adafruit/Adafruit-TLV320DAC3100-I2S-DAC-PCB/Adafruit TLV320DAC3100 I2S DAC.brd

## EAGLE design Adafruit TLV320DAC3100 I2S DAC.brd (2025-03-27)

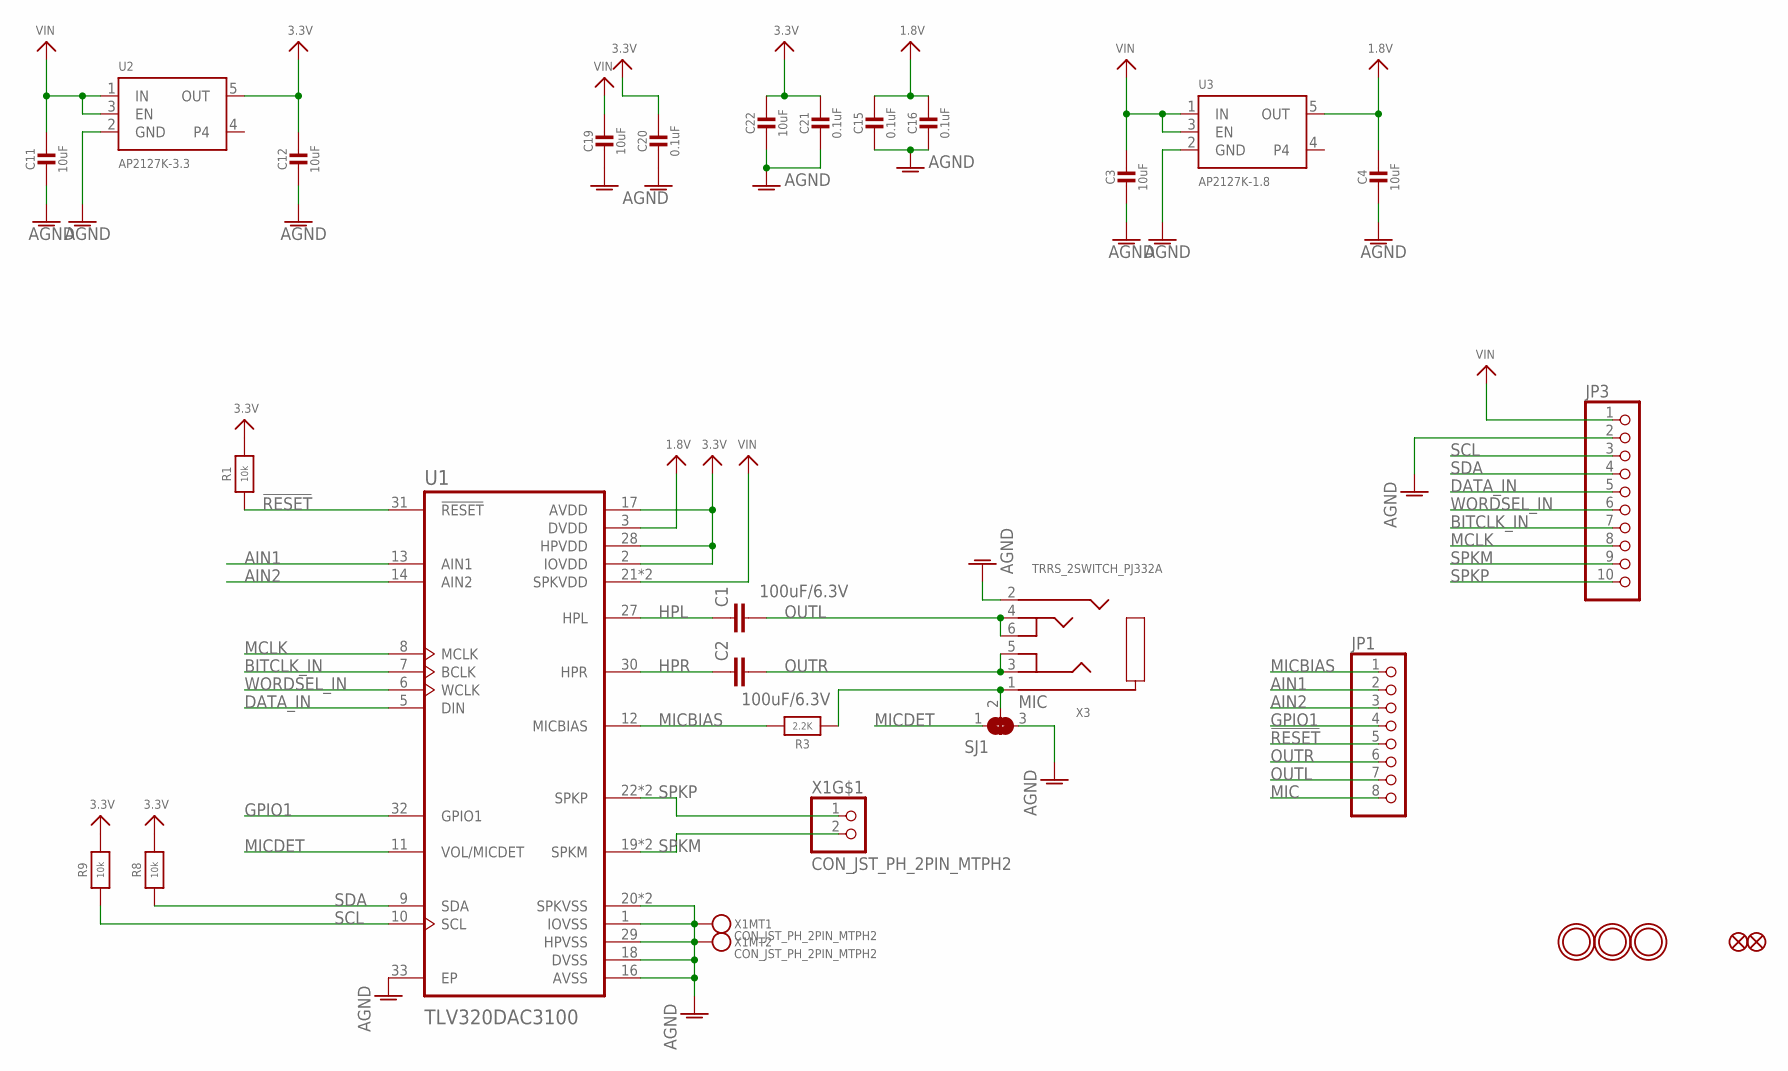
[picture p2: schematic Adafruit TLV320DAC3100 I2S DAC.sch]

Parts:
C1, C2: 100uF/6.3V; C1210
C3, C4, C11, C12, C19, C22: 10uF; 0805-NO
C15, C16, C20, C21: 0.1uF; 0603-NO
FID1, FID2: FIDUCIAL_0.5MM
JP1: HEADER-1X870MIL; 1X08_ROUND_70
JP3: HEADER-1X1070MIL; 1X10_ROUND70
R1, R8, R9: 10k; 0603-NO
R3: 2.2K; 0603-NO
SJ1: SOLDERJUMPER_2WAY; SOLDERJUMPER_2WAY_OPEN_NOPASTE
U1: TLV320DAC3100
U2: AP2127K-3.3; SOT23-5
U3: AP2127K-1.8; SOT23-5
U$12, U$13, U$14: MOUNTINGHOLE2.5; MOUNTINGHOLE_2.5_PLATED
X1: CON_JST_PH_2PIN_MTPH2; JSTPH2
X3: TRRS_2SWITCH_PJ332A; PJ-332A

Connections:
1.8V: C4.1, C15.1, C16.1, U1.3 (DVDD), U3.5 (OUT)
3.3V: C12.1, C20.1, C21.1, C22.1, R1.2, R8.2, R9.2, U1.2 (IOVDD), U1.17 (AVDD), U1.28 (HPVDD), U2.5 (OUT)
!RESET: JP1.5, R1.1, U1.31 (!RESET)
AGND: C3.2, C4.2, C11.2, C12.2, C15.2, C16.2, C19.2, C20.2, C21.2, C22.2, JP3.2, SJ1.3, U1.1 (IOVSS), U1.16 (AVSS), U1.18 (DVSS), U1.20 (SPKVSS), U1.25 (SPKVSS), U1.29 (HPVSS), U1.33 (EP), U2.2 (GND), U3.2 (GND), X1.NC1, X1.NC2, X3.2 (RING1)
AIN1: JP1.2, U1.13 (AIN1)
AIN2: JP1.3, U1.14 (AIN2)
BITCLK_IN: JP3.7, U1.7 (BCLK)
DATA_IN: JP3.5, U1.5 (DIN)
GPIO1: JP1.4, U1.32 (GPIO1)
HPL: C1.1, U1.27 (HPL)
HPR: C2.1, U1.30 (HPR)
MCLK: JP3.8, U1.8 (MCLK)
MIC: JP1.8, R3.1, SJ1.2, X3.1 (RING)
MICBIAS: JP1.1, R3.2, U1.12 (MICBIAS)
MICDET: SJ1.1, U1.11 (VOL/MICDET)
OUTL: C1.2, JP1.7, X3.4 (TIP), X3.6 (TIP_SW)
OUTR: C2.2, JP1.6, X3.3 (RING2), X3.5 (R2_SW)
SCL: JP3.3, R9.1, U1.10 (SCL)
SDA: JP3.4, R8.1, U1.9 (SDA)
SPKM: JP3.9, U1.19 (SPKM), U1.23 (SPKM), X1.2
SPKP: JP3.10, U1.22 (SPKP), U1.26 (SPKP), X1.1
VIN: C3.1, C11.1, C19.1, JP3.1, U1.21 (SPKVDD), U1.24 (SPKVDD), U2.1 (IN), U2.3 (EN), U3.1 (IN), U3.3 (EN)
WORDSEL_IN: JP3.6, U1.6 (WCLK)

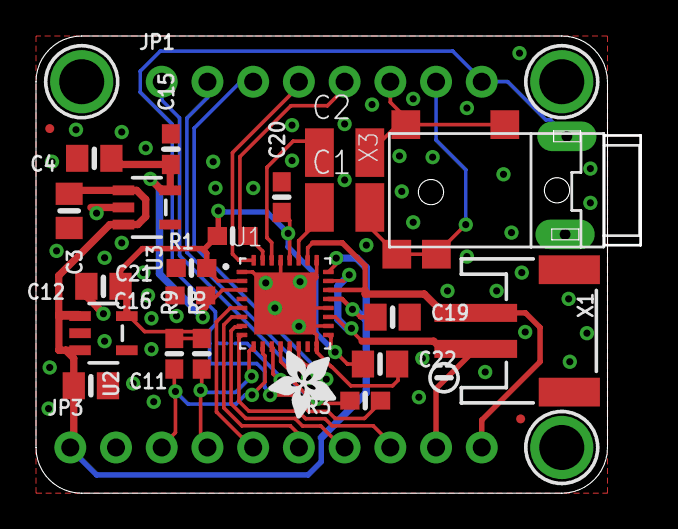
[picture p3: board Adafruit TLV320DAC3100 I2S DAC.brd from above]

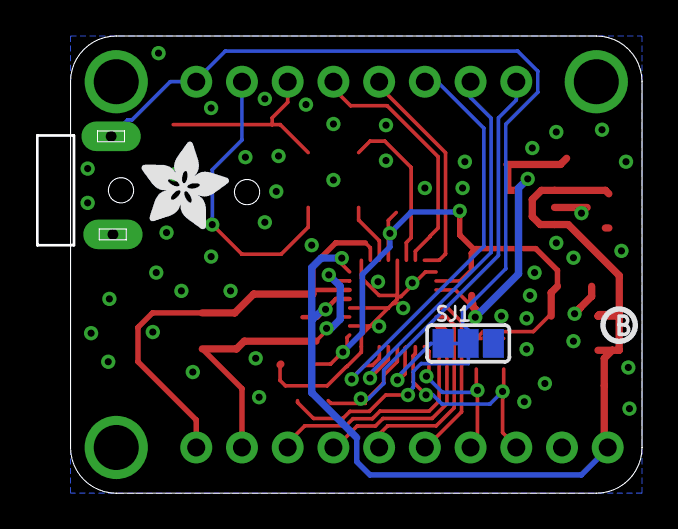
[picture p4: board Adafruit TLV320DAC3100 I2S DAC.brd from below]

Board: 2 copper layers, 33.6 x 25.4 mm, 60 parts (10 on the bottom side), 23 nets.

Other parts of the board:
E$1: SYMBOL_MINUS
PLABEL0: PLABEL0
PLABEL1: PLABEL1
PLABEL2: PLABEL2
PLABEL3: PLABEL3
PLABEL4: PLABEL4
PLABEL5: PLABEL5
PLABEL6: PLABEL6
PLABEL7: PLABEL7
PLABEL8: PLABEL8
PLABEL9: PLABEL9
PLABEL10: PLABEL10
PLABEL11: PLABEL11
PLABEL12: PLABEL12
PLABEL13: PLABEL13
PLABEL14: PLABEL14
PLABEL15: PLABEL15
PLABEL16: PLABEL16
PLABEL17: PLABEL17
PLABEL18: PLABEL18
PLABEL19: PLABEL19
PLABEL20: PLABEL20
PLABEL21: PLABEL21
PLABEL22: PLABEL22
PLABEL23: PLABEL23
PLABEL24: PLABEL24
PLABEL25: PLABEL25
PLABEL26: PLABEL26
U$5: PCBFEAT-REV-040
U$6: ADAFRUIT_5MM
U$29: ADAFRUIT_3.5MM
